mareyna356/banana-controlled-drone/Circuit.png

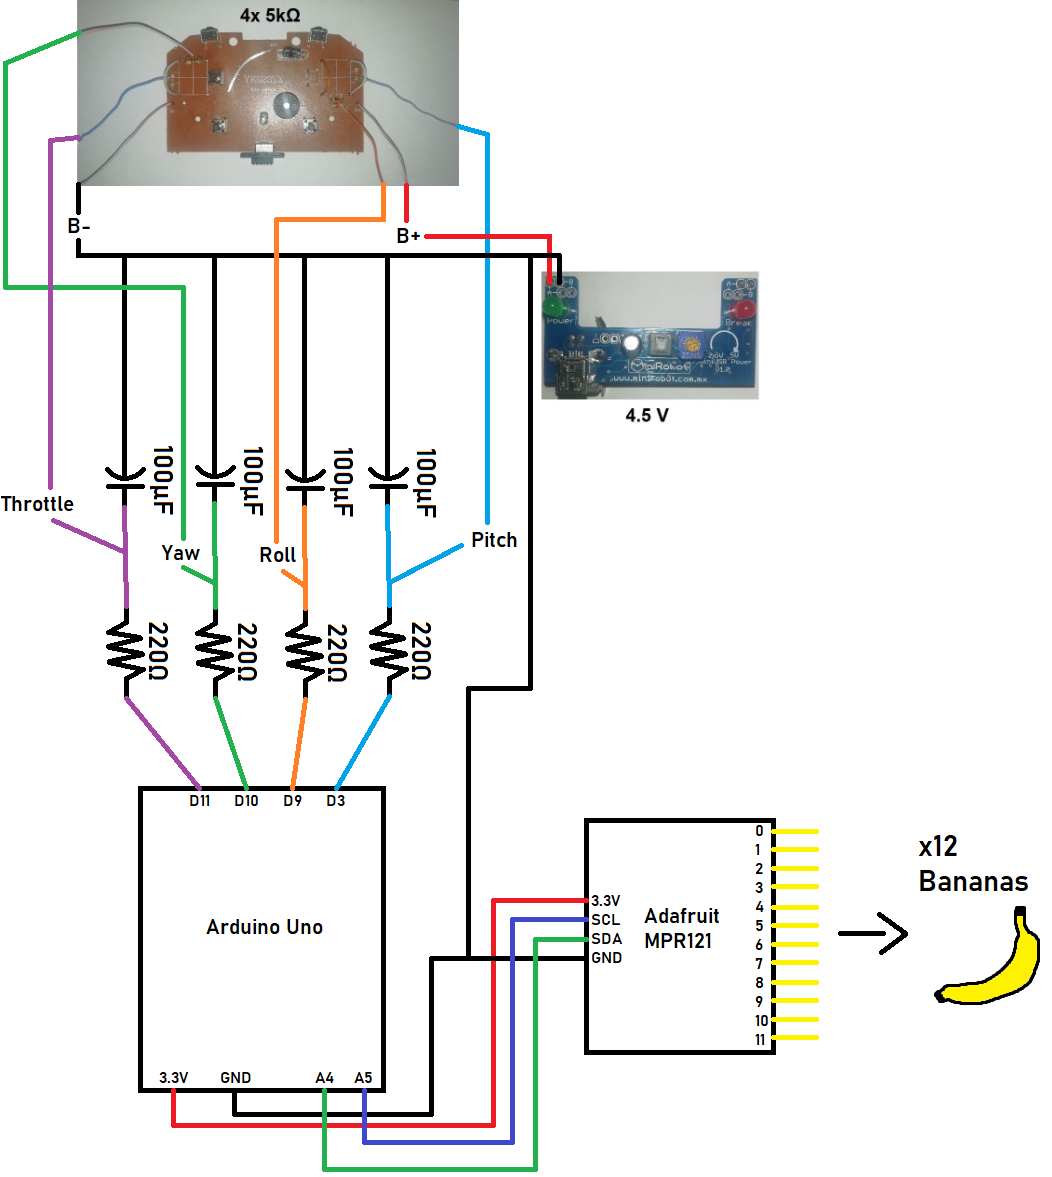
Circuit.png
